putzio/Altimetr/Dokumentacja/Schemat blokowy Puzio, Skrzypczak, Urban.png

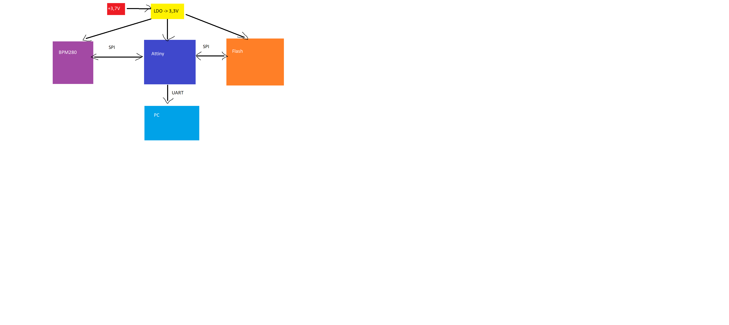
Dokumentacja/Schemat blokowy Puzio, Skrzypczak, Urban.png
