putzio/Altimetr/Altimetr_SPI/data/śruba.stl

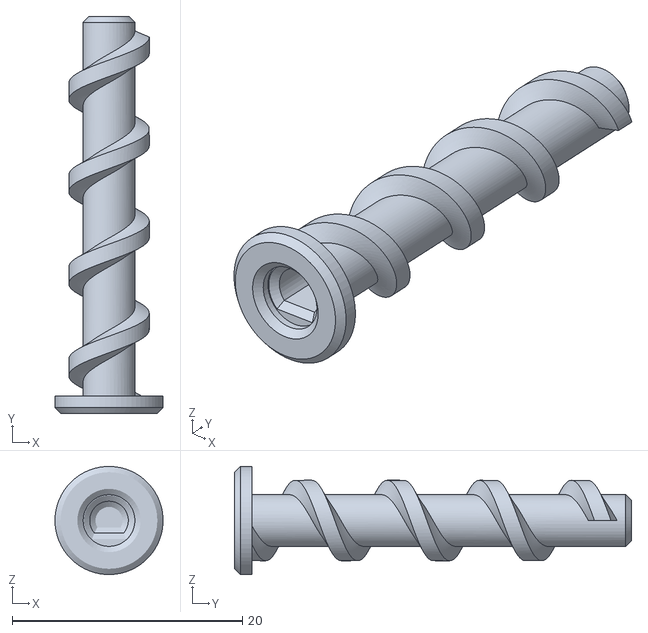
[picture p7: CAD file, 2022-06-03]
Altimetr_SPI/data/śruba.stl
9.39 x 34.5 x 9.40
