putzio/Altimetr/Elektro/shield.pdf

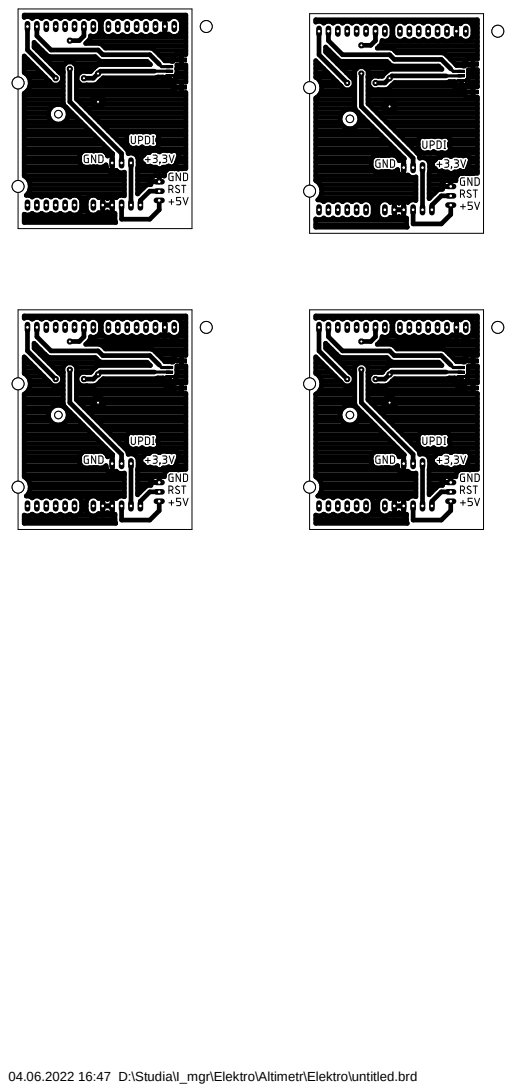
[picture p8: page 1]

04.06.2022 16:47 D:\Studia\I_mgr\Elektro\Altimetr\Elektro\untitled.brd
