putzio/Altimetr/Elektro/communication_shield.brd

## EAGLE design Elektro/communication_shield.brd (2022-06-12)

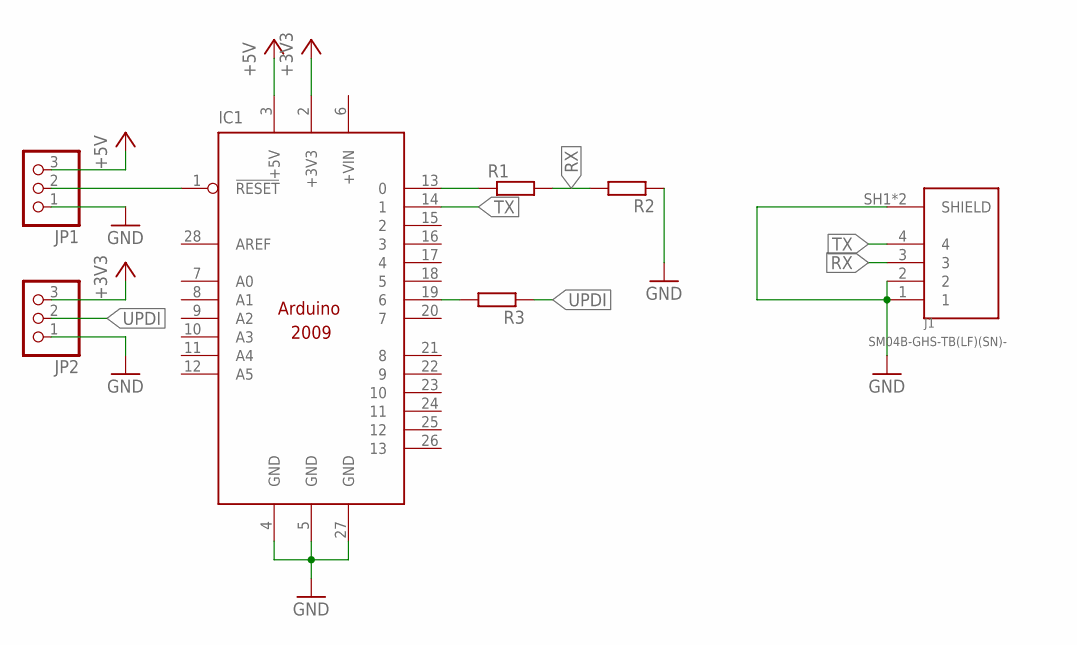
[picture p9: schematic communication_shield.sch]

Parts:
IC1: ARDUINO2009_10; ARDUINO2009
J1: SM04B-GHS-TB(LF)(SN)-; JST_SM04B-GHS-TB(LF)(SN)-
JP1, JP2: PINHD-1X3; 1X03
R1, R2, R3: R-EU_0204/7; 0204/7

Connections:
+3V3: IC1.2 (+3V3), JP2.3
+5V: IC1.3 (+5V), JP1.3
GND: IC1.4 (GND), IC1.5 (GND), IC1.27 (GND), J1.1, J1.2, J1.SH1 (SHIELD), J1.SH2 (SHIELD), JP1.1, JP2.1, R2.1
unnamed: IC1.19 (6), R3.2
unnamed: IC1.13 (0), R1.1
unnamed: IC1.1 (!RESET), JP1.2
RX: J1.3, R1.2, R2.2
TX: IC1.14 (1), J1.4
UPDI: JP2.2, R3.1

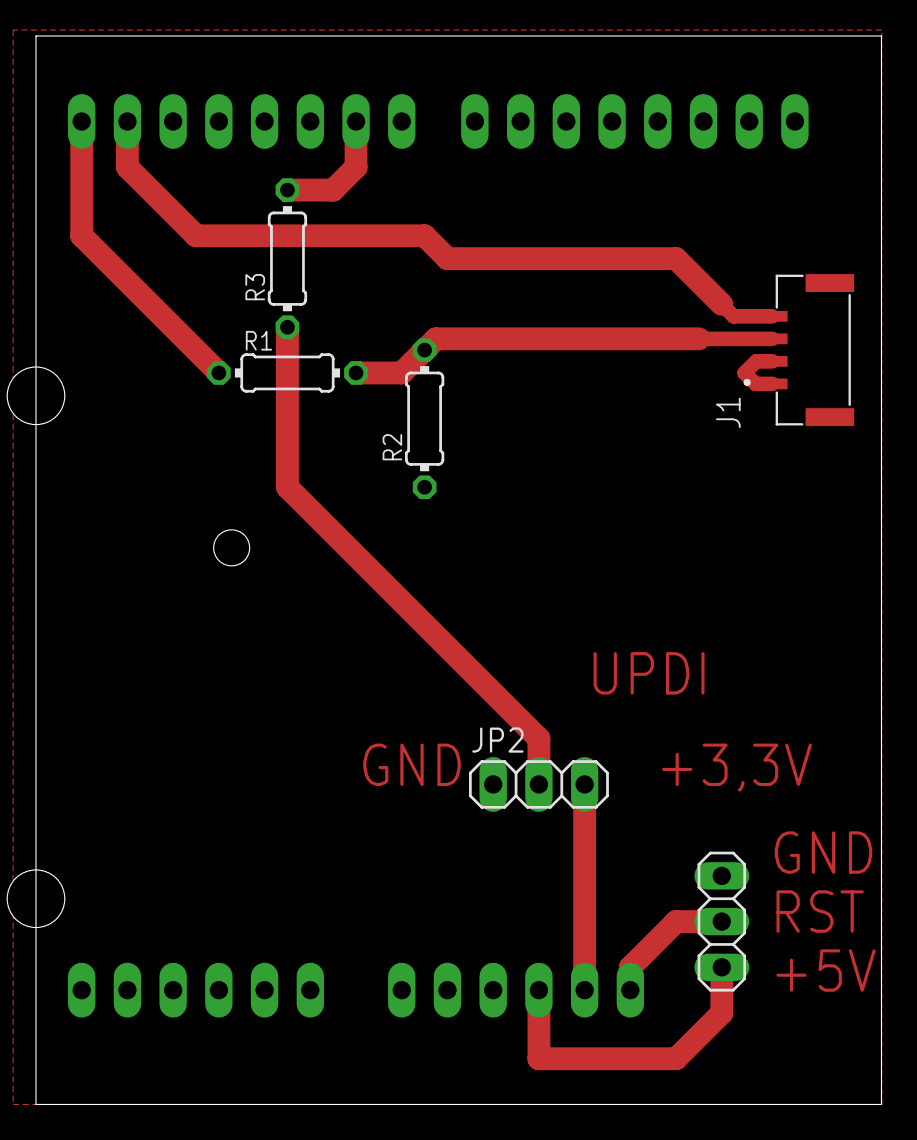
[picture p10: board communication_shield.brd from above]

Board: 2 copper layers, 47.0 x 59.4 mm, 7 parts (1 on the bottom side), 9 nets.
