putzio/Altimetr/Elektro/altimetrModul.brd

## EAGLE design Elektro/altimetrModul.brd (2022-05-24)

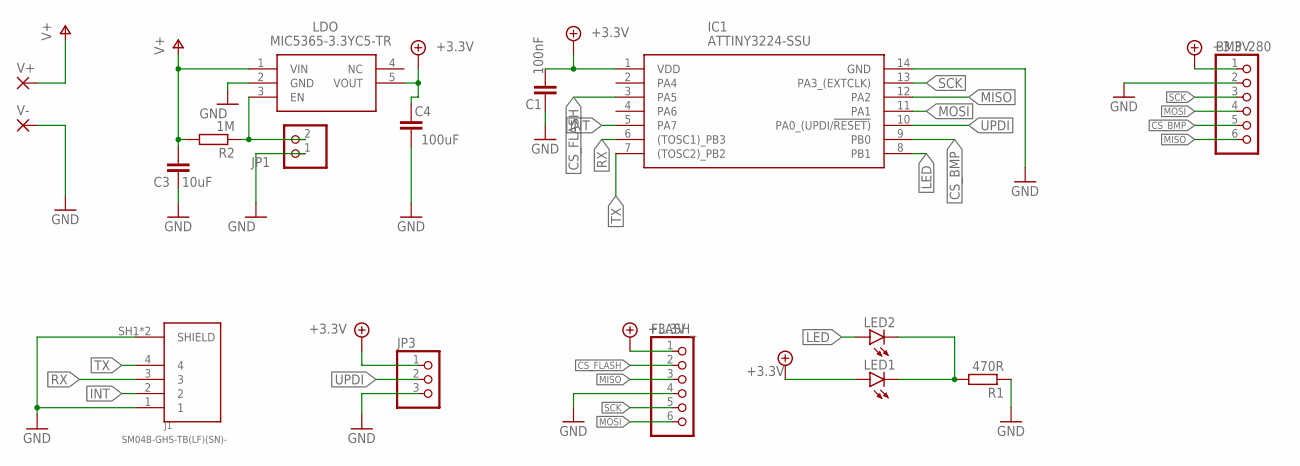
[picture p11: schematic altimetrModul.sch]

Parts:
BMP_280: PINHD-1X6; 1X06
C1: 100nF; C0805
C3: 10uF; C0805
C4: 100uF; C0805
FLASH_: PINHD-1X6; 1X06
IC1: ATTINY3224-SSU; SOIC127P600X175-14N
J1: SM04B-GHS-TB(LF)(SN)-; JST_SM04B-GHS-TB(LF)(SN)-
JP1: PINHD-1X2/90; 1X02/90
JP3: PINHD-1X3/90; 1X03/90
LDO: MIC5365-3.3YC5-TR; SOT65P210X110-5N
LED1, LED2: LEDCHIP-LED0805; CHIP-LED0805
R1: 470R; R0805
R2: 1M; R0805
V+: SMD2; SMD1,27-2,54
V-: SMD2; SMD1,27-2,54

Connections:
+3.3V: BMP_280.1, C1.1, C4.2, FLASH_.1, IC1.1 (VDD), JP3.1, LDO.5 (VOUT), LED1.A
CS_BMP: BMP_280.5, IC1.9 (PB0)
CS_FLASH: FLASH_.2, IC1.3 (PA5)
EN: JP1.2, LDO.3 (EN), R2.1
GND: BMP_280.2, C1.2, C3.1, C4.1, FLASH_.4, IC1.14 (GND), J1.1, J1.SH1 (SHIELD), J1.SH2 (SHIELD), JP1.1, JP3.3, LDO.2 (GND), R1.1, V-.1
INT: IC1.5 (PA7), J1.2
LED: IC1.8 (PB1), LED2.A
MISO: BMP_280.6, FLASH_.3, IC1.12 (PA2)
MOSI: BMP_280.4, FLASH_.6, IC1.11 (PA1)
unnamed: LED1.C, LED2.C, R1.2
RX: IC1.6 ((TOSC1)_PB3), J1.3
SCK: BMP_280.3, FLASH_.5, IC1.13 (PA3_(EXTCLK))
TX: IC1.7 ((TOSC2)_PB2), J1.4
UPDI: IC1.10 (PA0_(UPDI/!RESET)), JP3.2
V+: C3.2, LDO.1 (VIN), R2.2, V+.1

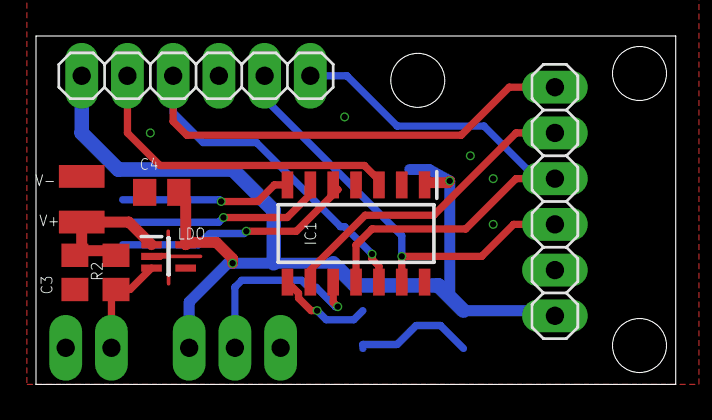
[picture p12: board altimetrModul.brd from above]

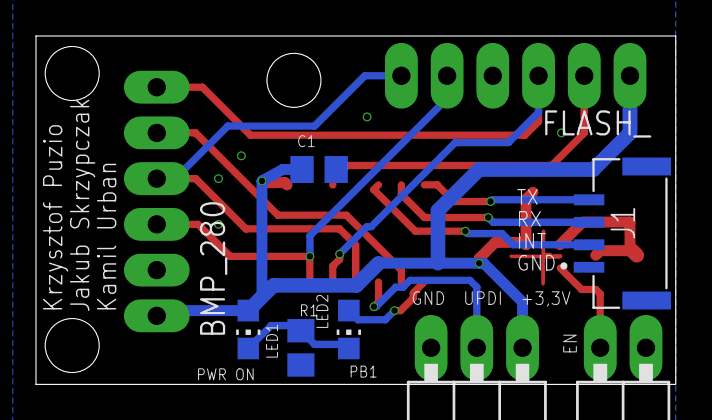
[picture p13: board altimetrModul.brd from below]

Board: 2 copper layers, 35.5 x 19.4 mm, 16 parts (7 on the bottom side), 15 nets.
