putzio/Altimetr/(commit log)

2022-03-31 Electro begin
    [altimetr.brd, altimetr.sch, altimetrModul.brd, altimetrModul.sch]
2022-04-03 Added Modules
    [altimetrModul.brd, altimetrModul.sch]
2022-04-04 Added names
    [altimetrModul.brd, altimetrModul.sch]
2022-04-10 Gerber generated in .zip
    [altimetrModul.brd, altimetrModul.sch]
2022-04-10 Names on the bottom layer
    [altimetrModul.brd]
2022-04-10 Gerberfile without pastemask
2022-05-16 Some new functions to order UART etc.
2022-05-16 NEEDs TESTsgit add .! Sending correct frame (#t:xx&h:xx$), clear flash, preassure
    [Altimetr_SPI.ino]
2022-05-17 Revert "test"
    This reverts commit 544f37aab3056d414bfdf0e580eea9a156e843a5.
    [Altimetr_SPI.ino]
2022-05-24 ATtiny 1624 changed to ATtiny 3224 (the memory size too small for all of the functionalities of the program
    [altimetrModul.brd, altimetrModul.sch]
2022-06-03 Connection works, hight changed to uint32_t (Long)
    [śruba.stl]
2022-06-12 Arduino communication shield, sending atmospheric preassure if asked
    [communication_shield.brd, communication_shield.sch]
2022-06-12 Final version
    [altimetr.sch]
